Gautam-Gandhi/4-bit-CLA-Adder---VLSI-Design/README.md

# 4-bit CLA Adder - VLSI-Design
VLSI Design of a 4-bit Carry Look-Ahead Adder
