Gautam-Gandhi/4-bit-CLA-Adder---VLSI-Design/MAGIC/test_complete_circuit.cir

* SPICE3 file created from pg_block.ext - technology: scmos

.option scale=90n
.include TSMC_180nm.txt

M1000 a0 a_n69_n411# gnd Gnd CMOSN w=10 l=2
+  ad=50p pd=30u as=50p ps=30u
M1001 a_n140_n1295# b3_ff_in gnd Gnd CMOSN w=10 l=2
+  ad=50p pd=30u as=50p ps=30u
M1002 a_n104_n1165# clk gnd Gnd CMOSN w=20 l=2
+  ad=100p pd=30u as=100p ps=50u
M1003 a_n104_n371# clk gnd Gnd CMOSN w=20 l=2
+  ad=100p pd=30u as=100p ps=50u
M1004 a_100_n781# c0 a_88_n781# Gnd CMOSN w=40 l=2
+  ad=0.2n pd=50u as=0.2n ps=50u
M1005 c4 g3_inv vdd vdd CMOSP w=20 l=2
+  ad=100p pd=50u as=100p ps=30u
M1006 a_n140_n936# clk a_n140_n1000# vdd CMOSP w=40 l=2
+  ad=0.2n pd=90u as=0.2n ps=50u
M1007 b0 a_n69_n447# gnd Gnd CMOSN w=10 l=2
+  ad=50p pd=30u as=50p ps=30u
M1008 vdd a_94_n825# c3 vdd CMOSP w=20 l=2
+  ad=100p pd=30u as=100p ps=30u
M1009 a_110_n1392# a_116_n1412# a_110_n1435# Gnd CMOSN w=20 l=2
+  ad=100p pd=50u as=100p ps=30u
M1010 out_NAND3 in1_NAND3 vdd vdd CMOSP w=20 l=2
+  ad=100p pd=30u as=100p ps=50u
M1011 g1 g1_inv gnd Gnd CMOSN w=10 l=2
+  ad=50p pd=30u as=50p ps=30u
M1012 s3_ff_out a_331_n656# vdd vdd CMOSP w=20 l=2
+  ad=100p pd=50u as=100p ps=50u
M1013 p2 a_34_n808# gnd Gnd CMOSN w=10 l=2
+  ad=50p pd=30u as=50p ps=30u
M1014 a_229_n1204# c4 gnd Gnd CMOSN w=10 l=2
+  ad=50p pd=30u as=50p ps=30u
M1015 a_118_n1118# c0 a_106_n1118# Gnd CMOSN w=50 l=2
+  ad=0.25n pd=60u as=0.25n ps=60u
M1016 g1_inv a1 vdd vdd CMOSP w=20 l=2
+  ad=100p pd=30u as=100p ps=50u
M1017 s2_ff_out_inv s2_ff_out vdd vdd CMOSP w=20 l=2
+  ad=100p pd=50u as=100p ps=50u
M1018 g1_inv b1 a_n6_n659# Gnd CMOSN w=20 l=2
+  ad=100p pd=50u as=100p ps=30u
M1019 c2 a_82_n504# vdd vdd CMOSP w=20 l=2
+  ad=100p pd=30u as=100p ps=50u
M1020 a_260_n556# clk a_260_n620# vdd CMOSP w=40 l=2
+  ad=0.2n pd=90u as=0.2n ps=50u
M1021 a_88_n704# p0 vdd vdd CMOSP w=20 l=2
+  ad=100p pd=30u as=100p ps=30u
M1022 p2 c2 a_151_n725# vdd CMOSP w=40 l=2
+  ad=0.2n pd=90u as=0.2n ps=90u
M1023 a_270_n786# a_223_n811# gnd Gnd CMOSN w=10 l=2
+  ad=50p pd=30u as=50p ps=30u
M1024 out_xor a_259_n60# vdd vdd CMOSP w=20 l=2
+  ad=100p pd=50u as=100p ps=50u
M1025 a_n104_n824# clk vdd vdd CMOSP w=20 l=2
+  ad=100p pd=50u as=100p ps=50u
M1026 vdd p2 a_100_n1287# vdd CMOSP w=20 l=2
+  ad=100p pd=30u as=100p ps=30u
M1027 a_94_n825# p2 a_106_n885# Gnd CMOSN w=30 l=2
+  ad=0.15n pd=70u as=0.15n ps=40u
M1028 a_100_n1347# g1 gnd Gnd CMOSN w=30 l=2
+  ad=0.15n pd=40u as=0.15n ps=70u
M1029 a_82_n504# p1 a_94_n564# Gnd CMOSN w=30 l=2
+  ad=0.15n pd=70u as=0.15n ps=40u
M1030 vdd b2 g2_inv vdd CMOSP w=20 l=2
+  ad=100p pd=50u as=100p ps=30u
M1031 a_62_n30# in_ff vdd vdd CMOSP w=40 l=2
+  ad=0.2n pd=50u as=0.2n ps=90u
M1032 in1_xor in2_xor a_212_n29# vdd CMOSP w=40 l=2
+  ad=0.2n pd=90u as=0.2n ps=90u
M1033 out_NAND4 in4_NAND4 a_163_n234# Gnd CMOSN w=40 l=2
+  ad=0.2n pd=90u as=0.2n ps=50u
M1034 p1 a_34_n572# vdd vdd CMOSP w=20 l=2
+  ad=100p pd=50u as=100p ps=50u
M1035 a_n104_n663# clk gnd Gnd CMOSN w=20 l=2
+  ad=100p pd=30u as=100p ps=50u
M1036 s1_ff_out a_333_n442# vdd vdd CMOSP w=20 l=2
+  ad=100p pd=50u as=100p ps=50u
M1037 c4_ff_out a_300_n1150# gnd Gnd CMOSN w=10 l=2
+  ad=50p pd=30u as=50p ps=30u
M1038 a_n69_n960# a_n104_n1000# gnd Gnd CMOSN w=20 l=2
+  ad=100p pd=30u as=100p ps=50u
M1039 s0_ff_out_inv s0_ff_out vdd vdd CMOSP w=20 l=2
+  ad=100p pd=50u as=100p ps=50u
M1040 a_n140_n677# clk a_n140_n643# vdd CMOSP w=40 l=2
+  ad=0.2n pd=90u as=0.2n ps=50u
M1041 a_158_n845# a_88_n704# gnd Gnd CMOSN w=40 l=2
+  ad=0.2n pd=50u as=0.2n ps=90u
M1042 a_262_n342# clk a_262_n406# vdd CMOSP w=40 l=2
+  ad=0.2n pd=90u as=0.2n ps=50u
M1043 a_100_n1287# p3 a_112_n1347# Gnd CMOSN w=30 l=2
+  ad=0.15n pd=70u as=0.15n ps=40u
M1044 c4_ff_out_inv c4_ff_out vdd vdd CMOSP w=20 l=2
+  ad=100p pd=50u as=100p ps=50u
M1045 a_77_n217# in2_NAND3 a_65_n217# Gnd CMOSN w=30 l=2
+  ad=0.15n pd=40u as=0.15n ps=40u
M1046 a_110_n1435# p3 gnd Gnd CMOSN w=20 l=2
+  ad=100p pd=30u as=100p ps=50u
M1047 a_262_n496# s1 gnd Gnd CMOSN w=10 l=2
+  ad=50p pd=30u as=50p ps=30u
M1048 a_n13_n541# b1 gnd Gnd CMOSN w=10 l=2
+  ad=50p pd=30u as=50p ps=30u
M1049 c0 a_n69_n1000# gnd Gnd CMOSN w=10 l=2
+  ad=50p pd=30u as=50p ps=30u
M1050 s2_ff_out_inv s2_ff_out gnd Gnd CMOSN w=10 l=2
+  ad=50p pd=30u as=50p ps=30u
M1051 g2 g2_inv vdd vdd CMOSP w=20 l=2
+  ad=100p pd=50u as=100p ps=50u
M1052 s3_ff_out_inv s3_ff_out gnd Gnd CMOSN w=10 l=2
+  ad=50p pd=30u as=50p ps=30u
M1053 a_265_n1190# clk gnd Gnd CMOSN w=20 l=2
+  ad=100p pd=30u as=100p ps=50u
M1054 a_n69_n1241# a_n104_n1241# vdd vdd CMOSP w=20 l=2
+  ad=100p pd=50u as=100p ps=50u
M1055 vdd in2_NAND5 out_NAND5 vdd CMOSP w=20 l=2
+  ad=100p pd=30u as=100p ps=30u
M1056 c0 p0 a_150_n403# vdd CMOSP w=40 l=2
+  ad=0.2n pd=90u as=0.2n ps=90u
M1057 a_n69_n587# clk a_n69_n547# Gnd CMOSN w=20 l=2
+  ad=100p pd=50u as=100p ps=30u
M1058 a_n104_n587# clk vdd vdd CMOSP w=20 l=2
+  ad=100p pd=50u as=100p ps=50u
M1059 a_331_n696# a_296_n656# gnd Gnd CMOSN w=20 l=2
+  ad=100p pd=30u as=100p ps=50u
M1060 a_n69_n900# a_n104_n860# gnd Gnd CMOSN w=20 l=2
+  ad=100p pd=30u as=100p ps=50u
M1061 g3_inv b3 a_n6_n1276# Gnd CMOSN w=20 l=2
+  ad=100p pd=50u as=100p ps=30u
M1062 a_n104_n860# clk vdd vdd CMOSP w=20 l=2
+  ad=100p pd=50u as=100p ps=50u
M1063 a_100_n1287# g1 vdd vdd CMOSP w=20 l=2
+  ad=100p pd=30u as=100p ps=50u
M1064 a_300_n1150# clk a_300_n1190# Gnd CMOSN w=20 l=2
+  ad=100p pd=50u as=100p ps=30u
M1065 a_62_n64# clk a_62_n30# vdd CMOSP w=40 l=2
+  ad=0.2n pd=90u as=0.2n ps=50u
M1066 c1 p1 a_169_n498# vdd CMOSP w=40 l=2
+  ad=0.2n pd=90u as=0.2n ps=90u
M1067 a_136_n564# a_82_n504# gnd Gnd CMOSN w=30 l=2
+  ad=0.15n pd=40u as=0.15n ps=70u
M1068 a_300_n1150# a_265_n1150# vdd vdd CMOSP w=20 l=2
+  ad=100p pd=50u as=100p ps=50u
M1069 a_n69_n1165# a_n104_n1205# gnd Gnd CMOSN w=20 l=2
+  ad=100p pd=30u as=100p ps=50u
M1070 vdd in2_NAND4 out_NAND4 vdd CMOSP w=20 l=2
+  ad=100p pd=30u as=100p ps=30u
M1071 a_82_n1024# p3 a_118_n1118# Gnd CMOSN w=50 l=2
+  ad=0.25n pd=0.11m as=0.25n ps=60u
M1072 s1 a_216_n473# gnd Gnd CMOSN w=10 l=2
+  ad=50p pd=30u as=50p ps=30u
M1073 vdd a_90_n1164# c4 vdd CMOSP w=20 l=2
+  ad=100p pd=30u as=100p ps=30u
M1074 vdd p1 a_90_n1164# vdd CMOSP w=20 l=2
+  ad=100p pd=30u as=100p ps=30u
M1075 a0 a_n69_n411# vdd vdd CMOSP w=20 l=2
+  ad=100p pd=50u as=100p ps=50u
M1076 a_100_n1287# p3 vdd vdd CMOSP w=20 l=2
+  ad=100p pd=50u as=100p ps=30u
M1077 vdd in2_NAND3 out_NAND3 vdd CMOSP w=20 l=2
+  ad=100p pd=30u as=100p ps=30u
M1078 a_216_n473# a_169_n498# vdd vdd CMOSP w=20 l=2
+  ad=100p pd=50u as=100p ps=50u
M1079 a_169_n498# c1 gnd Gnd CMOSN w=10 l=2
+  ad=50p pd=30u as=50p ps=30u
M1080 vdd a_82_n608# c2 vdd CMOSP w=20 l=2
+  ad=100p pd=30u as=100p ps=30u
M1081 a2 b2 a_n13_n777# vdd CMOSP w=40 l=2
+  ad=0.2n pd=90u as=0.2n ps=90u
M1082 a_98_n10# clk vdd vdd CMOSP w=20 l=2
+  ad=100p pd=50u as=100p ps=50u
M1083 a_n69_n447# clk a_n69_n487# Gnd CMOSN w=20 l=2
+  ad=100p pd=50u as=100p ps=30u
M1084 a_n104_n587# a_n140_n523# a_n104_n547# Gnd CMOSN w=20 l=2
+  ad=100p pd=50u as=100p ps=30u
M1085 vdd p1 a_88_n704# vdd CMOSP w=20 l=2
+  ad=100p pd=50u as=100p ps=30u
M1086 a_223_n811# p3 gnd Gnd CMOSN w=10 l=2
+  ad=50p pd=30u as=50p ps=30u
M1087 p3 c3 a_223_n811# vdd CMOSP w=40 l=2
+  ad=0.2n pd=90u as=0.2n ps=90u
M1088 a_82_n1024# p2 vdd vdd CMOSP w=20 l=2
+  ad=100p pd=30u as=100p ps=50u
M1089 a_139_n234# in1_NAND4 gnd Gnd CMOSN w=40 l=2
+  ad=0.2n pd=50u as=0.2n ps=90u
M1090 a_34_n383# a_n13_n352# gnd Gnd CMOSN w=10 l=2
+  ad=50p pd=30u as=50p ps=30u
M1091 out_inv in_inv gnd Gnd CMOSN w=10 l=2
+  ad=50p pd=30u as=50p ps=30u
M1092 a_n69_n371# a_n104_n411# gnd Gnd CMOSN w=20 l=2
+  ad=100p pd=30u as=100p ps=50u
M1093 a_n69_n1205# clk a_n69_n1165# Gnd CMOSN w=20 l=2
+  ad=100p pd=50u as=100p ps=30u
M1094 a_259_n60# a_212_n29# vdd vdd CMOSP w=20 l=2
+  ad=100p pd=50u as=100p ps=50u
M1095 vdd b1 g1_inv vdd CMOSP w=20 l=2
+  ad=100p pd=50u as=100p ps=30u
M1096 c0 a_n69_n1000# vdd vdd CMOSP w=20 l=2
+  ad=100p pd=50u as=100p ps=50u
M1097 a_n140_n760# a2_ff_in gnd Gnd CMOSN w=10 l=2
+  ad=50p pd=30u as=50p ps=30u
M1098 a_170_n845# a_94_n825# a_158_n845# Gnd CMOSN w=40 l=2
+  ad=0.2n pd=50u as=0.2n ps=50u
M1099 b3 a_n69_n1241# vdd vdd CMOSP w=20 l=2
+  ad=100p pd=50u as=100p ps=50u
M1100 out_NAND3 in3_NAND3 a_77_n217# Gnd CMOSN w=30 l=2
+  ad=0.15n pd=70u as=0.15n ps=40u
M1101 a_108_n400# a_73_n357# gnd Gnd CMOSN w=20 l=2
+  ad=100p pd=30u as=100p ps=50u
M1102 a_260_n556# s2 gnd Gnd CMOSN w=10 l=2
+  ad=50p pd=30u as=50p ps=30u
M1103 a_n69_n824# clk a_n69_n784# Gnd CMOSN w=20 l=2
+  ad=100p pd=50u as=100p ps=30u
M1104 c4 a_82_n1024# vdd vdd CMOSP w=20 l=2
+  ad=100p pd=30u as=100p ps=50u
M1105 in2_xor in1_xor a_212_n29# vdd CMOSP w=40 l=2
+  ad=0.2n pd=90u as=0.2n ps=90u
M1106 a_n69_n824# a_n104_n824# vdd vdd CMOSP w=20 l=2
+  ad=100p pd=50u as=100p ps=50u
M1107 a_333_n406# a_298_n406# vdd vdd CMOSP w=20 l=2
+  ad=100p pd=50u as=100p ps=50u
M1108 a_265_n1150# a_229_n1204# a_265_n1190# Gnd CMOSN w=20 l=2
+  ad=100p pd=50u as=100p ps=30u
M1109 a_n104_n447# a_n140_n501# a_n104_n487# Gnd CMOSN w=20 l=2
+  ad=100p pd=50u as=100p ps=30u
M1110 a_90_n1164# p2 vdd vdd CMOSP w=20 l=2
+  ad=100p pd=30u as=100p ps=50u
M1111 b0 a_n69_n447# vdd vdd CMOSP w=20 l=2
+  ad=100p pd=50u as=100p ps=50u
M1112 a_n104_n623# clk vdd vdd CMOSP w=20 l=2
+  ad=100p pd=50u as=100p ps=50u
M1113 a_n69_n663# a_n104_n623# gnd Gnd CMOSN w=20 l=2
+  ad=100p pd=30u as=100p ps=50u
M1114 a_88_n704# p2 vdd vdd CMOSP w=20 l=2
+  ad=100p pd=30u as=100p ps=50u
M1115 a_n6_n1276# a3 gnd Gnd CMOSN w=20 l=2
+  ad=100p pd=30u as=100p ps=50u
M1116 g1 g1_inv vdd vdd CMOSP w=20 l=2
+  ad=100p pd=50u as=100p ps=50u
M1117 out_NAND5 in3_NAND5 vdd vdd CMOSP w=20 l=2
+  ad=100p pd=30u as=100p ps=30u
M1118 c4 g3_inv a_197_n1258# Gnd CMOSN w=50 l=2
+  ad=0.25n pd=0.11m as=0.25n ps=60u
M1119 p3 a_34_n1189# gnd Gnd CMOSN w=10 l=2
+  ad=50p pd=30u as=50p ps=30u
M1120 a_n13_n1158# b3 gnd Gnd CMOSN w=10 l=2
+  ad=50p pd=30u as=50p ps=30u
M1121 a_n104_n547# clk gnd Gnd CMOSN w=20 l=2
+  ad=100p pd=30u as=100p ps=50u
M1122 b1 a_n69_n623# gnd Gnd CMOSN w=10 l=2
+  ad=50p pd=30u as=50p ps=30u
M1123 c4 a_100_n1287# vdd vdd CMOSP w=20 l=2
+  ad=100p pd=30u as=100p ps=30u
M1124 a_90_n1164# p3 vdd vdd CMOSP w=20 l=2
+  ad=100p pd=30u as=100p ps=30u
M1125 a_148_n564# a_82_n608# a_136_n564# Gnd CMOSN w=30 l=2
+  ad=0.15n pd=40u as=0.15n ps=40u
M1126 a_n140_n501# b0_ff_in gnd Gnd CMOSN w=10 l=2
+  ad=50p pd=30u as=50p ps=30u
M1127 a_n104_n824# a_n140_n760# a_n104_n784# Gnd CMOSN w=20 l=2
+  ad=100p pd=50u as=100p ps=30u
M1128 a0 b0 a_n13_n352# vdd CMOSP w=40 l=2
+  ad=0.2n pd=90u as=0.2n ps=90u
M1129 a_n13_n777# b2 gnd Gnd CMOSN w=10 l=2
+  ad=50p pd=30u as=50p ps=30u
M1130 a_n140_n880# b2_ff_in vdd vdd CMOSP w=40 l=2
+  ad=0.2n pd=50u as=0.2n ps=90u
M1131 a_73_n400# p0 gnd Gnd CMOSN w=20 l=2
+  ad=100p pd=30u as=100p ps=50u
M1132 c4_ff_out a_300_n1150# vdd vdd CMOSP w=20 l=2
+  ad=100p pd=50u as=100p ps=50u
M1133 a_34_n1189# a_n13_n1158# gnd Gnd CMOSN w=10 l=2
+  ad=50p pd=30u as=50p ps=30u
M1134 vdd b3 g3_inv vdd CMOSP w=20 l=2
+  ad=100p pd=50u as=100p ps=30u
M1135 out_NAND3 in3_NAND3 vdd vdd CMOSP w=20 l=2
+  ad=100p pd=50u as=100p ps=30u
M1136 a_n140_n411# a0_ff_in vdd vdd CMOSP w=40 l=2
+  ad=0.2n pd=50u as=0.2n ps=90u
M1137 a_n69_n587# a_n104_n587# vdd vdd CMOSP w=20 l=2
+  ad=100p pd=50u as=100p ps=50u
M1138 a_260_n676# s3 vdd vdd CMOSP w=40 l=2
+  ad=0.2n pd=50u as=0.2n ps=90u
M1139 a_265_n1150# clk vdd vdd CMOSP w=20 l=2
+  ad=100p pd=50u as=100p ps=50u
M1140 vdd p1 a_82_n1024# vdd CMOSP w=20 l=2
+  ad=100p pd=30u as=100p ps=30u
M1141 a_331_n656# a_296_n656# vdd vdd CMOSP w=20 l=2
+  ad=100p pd=50u as=100p ps=50u
M1142 a_283_n251# in4_NAND5 a_271_n251# Gnd CMOSN w=50 l=2
+  ad=0.25n pd=60u as=0.25n ps=60u
M1143 p0 a_34_n383# gnd Gnd CMOSN w=10 l=2
+  ad=50p pd=30u as=50p ps=30u
M1144 c2 g1_inv vdd vdd CMOSP w=20 l=2
+  ad=100p pd=50u as=100p ps=30u
M1145 a_n69_n860# a_n104_n860# vdd vdd CMOSP w=20 l=2
+  ad=100p pd=50u as=100p ps=50u
M1146 a_296_n620# clk vdd vdd CMOSP w=20 l=2
+  ad=100p pd=50u as=100p ps=50u
M1147 a_n140_n760# clk a_n140_n824# vdd CMOSP w=40 l=2
+  ad=0.2n pd=90u as=0.2n ps=50u
M1148 a_n104_n487# clk gnd Gnd CMOSN w=20 l=2
+  ad=100p pd=30u as=100p ps=50u
M1149 a_n140_n523# a1_ff_in gnd Gnd CMOSN w=10 l=2
+  ad=50p pd=30u as=50p ps=30u
M1150 a_331_n580# a_296_n620# gnd Gnd CMOSN w=20 l=2
+  ad=100p pd=30u as=100p ps=50u
M1151 b2 a2 a_n13_n777# vdd CMOSP w=40 l=2
+  ad=0.2n pd=90u as=0.2n ps=90u
M1152 out_xor a_259_n60# gnd Gnd CMOSN w=10 l=2
+  ad=50p pd=30u as=50p ps=30u
M1153 a_151_n234# in2_NAND4 a_139_n234# Gnd CMOSN w=40 l=2
+  ad=0.2n pd=50u as=0.2n ps=50u
M1154 g3 g3_inv vdd vdd CMOSP w=20 l=2
+  ad=100p pd=50u as=100p ps=50u
M1155 a_n6_n470# a0 gnd Gnd CMOSN w=20 l=2
+  ad=100p pd=30u as=100p ps=50u
M1156 s3_ff_out_inv s3_ff_out vdd vdd CMOSP w=20 l=2
+  ad=100p pd=50u as=100p ps=50u
M1157 a_n6_n200# in1_NAND2 gnd Gnd CMOSN w=20 l=2
+  ad=100p pd=30u as=100p ps=50u
M1158 a_n140_n501# clk a_n140_n467# vdd CMOSP w=40 l=2
+  ad=0.2n pd=90u as=0.2n ps=50u
M1159 a_102_n1241# p1 a_90_n1241# Gnd CMOSN w=40 l=2
+  ad=0.2n pd=50u as=0.2n ps=50u
M1160 a_n140_n1000# c0_ff_in vdd vdd CMOSP w=40 l=2
+  ad=0.2n pd=50u as=0.2n ps=90u
M1161 s0_ff_out a_333_n406# gnd Gnd CMOSN w=10 l=2
+  ad=50p pd=30u as=50p ps=30u
M1162 c2 p2 a_151_n725# vdd CMOSP w=40 l=2
+  ad=0.2n pd=90u as=0.2n ps=90u
M1163 c3 a_94_n929# vdd vdd CMOSP w=20 l=2
+  ad=100p pd=30u as=100p ps=30u
M1164 s3 a_270_n786# gnd Gnd CMOSN w=10 l=2
+  ad=50p pd=30u as=50p ps=30u
M1165 a_94_n825# p1 vdd vdd CMOSP w=20 l=2
+  ad=100p pd=30u as=100p ps=50u
M1166 a_82_n504# c0 vdd vdd CMOSP w=20 l=2
+  ad=100p pd=30u as=100p ps=50u
M1167 a_333_n482# a_298_n442# gnd Gnd CMOSN w=20 l=2
+  ad=100p pd=30u as=100p ps=50u
M1168 s1_ff_out a_333_n442# gnd Gnd CMOSN w=10 l=2
+  ad=50p pd=30u as=50p ps=30u
M1169 c1 g0_inv a_108_n400# Gnd CMOSN w=20 l=2
+  ad=100p pd=50u as=100p ps=30u
M1170 a_298_n406# clk vdd vdd CMOSP w=20 l=2
+  ad=100p pd=50u as=100p ps=50u
M1171 a2 a_n69_n824# gnd Gnd CMOSN w=10 l=2
+  ad=50p pd=30u as=50p ps=30u
M1172 a_270_n786# a_223_n811# vdd vdd CMOSP w=20 l=2
+  ad=100p pd=50u as=100p ps=50u
M1173 a_n104_n784# clk gnd Gnd CMOSN w=20 l=2
+  ad=100p pd=30u as=100p ps=50u
M1174 a_n140_n1141# a3_ff_in gnd Gnd CMOSN w=10 l=2
+  ad=50p pd=30u as=50p ps=30u
M1175 b2 a_n69_n860# gnd Gnd CMOSN w=10 l=2
+  ad=50p pd=30u as=50p ps=30u
M1176 vdd a_116_n1412# a_110_n1392# vdd CMOSP w=20 l=2
+  ad=100p pd=50u as=100p ps=30u
M1177 s1_ff_out_inv s1_ff_out vdd vdd CMOSP w=20 l=2
+  ad=100p pd=50u as=100p ps=50u
M1178 vdd c0 a_88_n704# vdd CMOSP w=20 l=2
+  ad=100p pd=30u as=100p ps=30u
M1179 a_94_n929# p2 vdd vdd CMOSP w=20 l=2
+  ad=100p pd=30u as=100p ps=50u
M1180 a_n104_n1241# a_n140_n1295# a_n104_n1281# Gnd CMOSN w=20 l=2
+  ad=100p pd=50u as=100p ps=30u
M1181 vdd a_110_n1392# c4 vdd CMOSP w=20 l=2
+  ad=100p pd=30u as=100p ps=30u
M1182 vdd g0 a_90_n1164# vdd CMOSP w=20 l=2
+  ad=100p pd=50u as=100p ps=30u
M1183 a_296_n656# a_260_n710# a_296_n696# Gnd CMOSN w=20 l=2
+  ad=100p pd=50u as=100p ps=30u
M1184 c1 a_73_n357# vdd vdd CMOSP w=20 l=2
+  ad=100p pd=30u as=100p ps=50u
M1185 a_82_n608# g0 vdd vdd CMOSP w=20 l=2
+  ad=100p pd=30u as=100p ps=50u
M1186 g2 g2_inv gnd Gnd CMOSN w=10 l=2
+  ad=50p pd=30u as=50p ps=30u
M1187 a_173_n1258# a_90_n1164# a_161_n1258# Gnd CMOSN w=50 l=2
+  ad=0.25n pd=60u as=0.25n ps=60u
M1188 a_n140_n523# clk a_n140_n587# vdd CMOSP w=40 l=2
+  ad=0.2n pd=90u as=0.2n ps=50u
M1189 a_82_n1024# p0 vdd vdd CMOSP w=20 l=2
+  ad=100p pd=30u as=100p ps=30u
M1190 a_n140_n643# b1_ff_in vdd vdd CMOSP w=40 l=2
+  ad=0.2n pd=50u as=0.2n ps=90u
M1191 a_112_n781# p0 a_100_n781# Gnd CMOSN w=40 l=2
+  ad=0.2n pd=50u as=0.2n ps=50u
M1192 c2 g1_inv a_148_n564# Gnd CMOSN w=30 l=2
+  ad=0.15n pd=70u as=0.15n ps=40u
M1193 a_34_n383# a_n13_n352# vdd vdd CMOSP w=20 l=2
+  ad=100p pd=50u as=100p ps=50u
M1194 a_198_n700# a_151_n725# gnd Gnd CMOSN w=10 l=2
+  ad=50p pd=30u as=50p ps=30u
M1195 g3_inv a3 vdd vdd CMOSP w=20 l=2
+  ad=100p pd=30u as=100p ps=50u
M1196 out_inv in_inv vdd vdd CMOSP w=20 l=2
+  ad=100p pd=50u as=100p ps=50u
M1197 a_260_n710# s3 gnd Gnd CMOSN w=10 l=2
+  ad=50p pd=30u as=50p ps=30u
M1198 a_229_n1170# c4 vdd vdd CMOSP w=40 l=2
+  ad=0.2n pd=50u as=0.2n ps=90u
M1199 a_n104_n1205# clk vdd vdd CMOSP w=20 l=2
+  ad=100p pd=50u as=100p ps=50u
M1200 a_n104_n411# clk vdd vdd CMOSP w=20 l=2
+  ad=100p pd=50u as=100p ps=50u
M1201 a_73_n357# c0 a_73_n400# Gnd CMOSN w=20 l=2
+  ad=100p pd=50u as=100p ps=30u
M1202 a_298_n442# a_262_n496# a_298_n482# Gnd CMOSN w=20 l=2
+  ad=100p pd=50u as=100p ps=30u
M1203 a_n69_n623# a_n104_n623# vdd vdd CMOSP w=20 l=2
+  ad=100p pd=50u as=100p ps=50u
M1204 a_90_n1241# p2 gnd Gnd CMOSN w=40 l=2
+  ad=0.2n pd=50u as=0.2n ps=90u
M1205 a_82_n1118# p2 gnd Gnd CMOSN w=50 l=2
+  ad=0.25n pd=60u as=0.25n ps=0.11m
M1206 a_94_n972# p2 gnd Gnd CMOSN w=20 l=2
+  ad=100p pd=30u as=100p ps=50u
M1207 out_ff a_133_n10# gnd Gnd CMOSN w=10 l=2
+  ad=50p pd=30u as=50p ps=30u
M1208 p0 c0 a_150_n403# vdd CMOSP w=40 l=2
+  ad=0.2n pd=90u as=0.2n ps=90u
M1209 a_82_n651# g0 gnd Gnd CMOSN w=20 l=2
+  ad=100p pd=30u as=100p ps=50u
M1210 a_296_n696# clk gnd Gnd CMOSN w=20 l=2
+  ad=100p pd=30u as=100p ps=50u
M1211 a_247_n251# in1_NAND5 gnd Gnd CMOSN w=50 l=2
+  ad=0.25n pd=60u as=0.25n ps=0.11m
M1212 b0 a0 a_n13_n352# vdd CMOSP w=40 l=2
+  ad=0.2n pd=90u as=0.2n ps=90u
M1213 a_110_n1392# p3 vdd vdd CMOSP w=20 l=2
+  ad=100p pd=30u as=100p ps=50u
M1214 a_n140_n1261# b3_ff_in vdd vdd CMOSP w=40 l=2
+  ad=0.2n pd=50u as=0.2n ps=90u
M1215 b3 a3 a_n13_n1158# vdd CMOSP w=40 l=2
+  ad=0.2n pd=90u as=0.2n ps=90u
M1216 a_260_n620# s2 vdd vdd CMOSP w=40 l=2
+  ad=0.2n pd=50u as=0.2n ps=90u
M1217 a_n6_n895# a2 gnd Gnd CMOSN w=20 l=2
+  ad=100p pd=30u as=100p ps=50u
M1218 a_94_n885# p1 gnd Gnd CMOSN w=30 l=2
+  ad=0.15n pd=40u as=0.15n ps=70u
M1219 out_NAND5 in5_NAND5 a_283_n251# Gnd CMOSN w=50 l=2
+  ad=0.25n pd=0.11m as=0.25n ps=60u
M1220 a_262_n342# s0 gnd Gnd CMOSN w=10 l=2
+  ad=50p pd=30u as=50p ps=30u
M1221 a_n69_n547# a_n104_n587# gnd Gnd CMOSN w=20 l=2
+  ad=100p pd=30u as=100p ps=50u
M1222 a_34_n572# a_n13_n541# gnd Gnd CMOSN w=10 l=2
+  ad=50p pd=30u as=50p ps=30u
M1223 a_82_n564# c0 gnd Gnd CMOSN w=30 l=2
+  ad=0.15n pd=40u as=0.15n ps=70u
M1224 a_331_n656# clk a_331_n696# Gnd CMOSN w=20 l=2
+  ad=100p pd=50u as=100p ps=30u
M1225 s2_ff_out a_331_n620# vdd vdd CMOSP w=20 l=2
+  ad=100p pd=50u as=100p ps=50u
M1226 a_114_n1241# p3 a_102_n1241# Gnd CMOSN w=40 l=2
+  ad=0.2n pd=50u as=0.2n ps=50u
M1227 a_73_n357# p0 vdd vdd CMOSP w=20 l=2
+  ad=100p pd=30u as=100p ps=50u
M1228 a_161_n1258# a_82_n1024# gnd Gnd CMOSN w=50 l=2
+  ad=0.25n pd=60u as=0.25n ps=0.11m
M1229 out_NAND4 in3_NAND4 vdd vdd CMOSP w=20 l=2
+  ad=100p pd=30u as=100p ps=30u
M1230 a_n104_n1000# clk vdd vdd CMOSP w=20 l=2
+  ad=100p pd=50u as=100p ps=50u
M1231 a_n69_n1000# clk a_n69_n960# Gnd CMOSN w=20 l=2
+  ad=100p pd=50u as=100p ps=30u
M1232 a_298_n482# clk gnd Gnd CMOSN w=20 l=2
+  ad=100p pd=30u as=100p ps=50u
M1233 s1 a_216_n473# vdd vdd CMOSP w=20 l=2
+  ad=100p pd=50u as=100p ps=50u
M1234 a1 a_n69_n587# gnd Gnd CMOSN w=10 l=2
+  ad=50p pd=30u as=50p ps=30u
M1235 vdd p0 a_82_n504# vdd CMOSP w=20 l=2
+  ad=100p pd=30u as=100p ps=30u
M1236 a_333_n442# clk a_333_n482# Gnd CMOSN w=20 l=2
+  ad=100p pd=50u as=100p ps=30u
M1237 vdd g2_inv c3 vdd CMOSP w=20 l=2
+  ad=100p pd=50u as=100p ps=30u
M1238 a3 a_n69_n1205# gnd Gnd CMOSN w=10 l=2
+  ad=50p pd=30u as=50p ps=30u
M1239 a_259_n60# a_212_n29# gnd Gnd CMOSN w=10 l=2
+  ad=50p pd=30u as=50p ps=30u
M1240 s0_ff_out a_333_n406# vdd vdd CMOSP w=20 l=2
+  ad=100p pd=50u as=100p ps=50u
M1241 a_197_n378# a_150_n403# gnd Gnd CMOSN w=10 l=2
+  ad=50p pd=30u as=50p ps=30u
M1242 g0 g0_inv gnd Gnd CMOSN w=10 l=2
+  ad=50p pd=30u as=50p ps=30u
M1243 b3 a_n69_n1241# gnd Gnd CMOSN w=10 l=2
+  ad=50p pd=30u as=50p ps=30u
M1244 a_n69_n487# a_n104_n447# gnd Gnd CMOSN w=20 l=2
+  ad=100p pd=30u as=100p ps=50u
M1245 g0_inv b0 a_n6_n470# Gnd CMOSN w=20 l=2
+  ad=100p pd=50u as=100p ps=30u
M1246 a2 a_n69_n824# vdd vdd CMOSP w=20 l=2
+  ad=100p pd=50u as=100p ps=50u
M1247 a_185_n1258# a_100_n1287# a_173_n1258# Gnd CMOSN w=50 l=2
+  ad=0.25n pd=60u as=0.25n ps=60u
M1248 a_n140_n1295# clk a_n140_n1261# vdd CMOSP w=40 l=2
+  ad=0.2n pd=90u as=0.2n ps=50u
M1249 a_212_n29# in1_xor gnd Gnd CMOSN w=10 l=2
+  ad=50p pd=30u as=50p ps=30u
M1250 out_NAND2 in1_NAND2 vdd vdd CMOSP w=20 l=2
+  ad=100p pd=30u as=100p ps=50u
M1251 out_NAND2 in2_NAND2 a_n6_n200# Gnd CMOSN w=20 l=2
+  ad=100p pd=50u as=100p ps=30u
M1252 g0_inv a0 vdd vdd CMOSP w=20 l=2
+  ad=100p pd=30u as=100p ps=50u
M1253 a_n104_n447# clk vdd vdd CMOSP w=20 l=2
+  ad=100p pd=50u as=100p ps=50u
M1254 a_198_n700# a_151_n725# vdd vdd CMOSP w=20 l=2
+  ad=100p pd=50u as=100p ps=50u
M1255 vdd c0 a_82_n1024# vdd CMOSP w=20 l=2
+  ad=100p pd=30u as=100p ps=30u
M1256 s2_ff_out a_331_n620# gnd Gnd CMOSN w=10 l=2
+  ad=50p pd=30u as=50p ps=30u
M1257 a_34_n808# a_n13_n777# vdd vdd CMOSP w=20 l=2
+  ad=100p pd=50u as=100p ps=50u
M1258 a_133_n50# a_98_n10# gnd Gnd CMOSN w=20 l=2
+  ad=100p pd=30u as=100p ps=50u
M1259 vdd g0_inv c1 vdd CMOSP w=20 l=2
+  ad=100p pd=50u as=100p ps=30u
M1260 a_262_n462# s1 vdd vdd CMOSP w=40 l=2
+  ad=0.2n pd=50u as=0.2n ps=90u
M1261 vdd p1 a_82_n608# vdd CMOSP w=20 l=2
+  ad=100p pd=50u as=100p ps=30u
M1262 a_n69_n860# clk a_n69_n900# Gnd CMOSN w=20 l=2
+  ad=100p pd=50u as=100p ps=30u
M1263 a_n104_n1000# a_n140_n936# a_n104_n960# Gnd CMOSN w=20 l=2
+  ad=100p pd=50u as=100p ps=30u
M1264 p0 a_34_n383# vdd vdd CMOSP w=20 l=2
+  ad=100p pd=50u as=100p ps=50u
M1265 a_333_n442# a_298_n442# vdd vdd CMOSP w=20 l=2
+  ad=100p pd=50u as=100p ps=50u
M1266 s3_ff_out a_331_n656# gnd Gnd CMOSN w=10 l=2
+  ad=50p pd=30u as=50p ps=30u
M1267 a_n104_n1281# clk gnd Gnd CMOSN w=20 l=2
+  ad=100p pd=30u as=100p ps=50u
M1268 a_229_n1204# clk a_229_n1170# vdd CMOSP w=40 l=2
+  ad=0.2n pd=90u as=0.2n ps=50u
M1269 a_98_n50# clk gnd Gnd CMOSN w=20 l=2
+  ad=100p pd=30u as=100p ps=50u
M1270 a_98_n10# a_62_n64# a_98_n50# Gnd CMOSN w=20 l=2
+  ad=100p pd=50u as=100p ps=30u
M1271 a1 b1 a_n13_n541# vdd CMOSP w=40 l=2
+  ad=0.2n pd=90u as=0.2n ps=90u
M1272 s2 a_198_n700# gnd Gnd CMOSN w=10 l=2
+  ad=50p pd=30u as=50p ps=30u
M1273 a_88_n704# p1 a_112_n781# Gnd CMOSN w=40 l=2
+  ad=0.2n pd=90u as=0.2n ps=50u
M1274 a_182_n845# a_94_n929# a_170_n845# Gnd CMOSN w=40 l=2
+  ad=0.2n pd=50u as=0.2n ps=50u
M1275 a_n69_n1205# a_n104_n1205# vdd vdd CMOSP w=20 l=2
+  ad=100p pd=50u as=100p ps=50u
M1276 a_94_n1118# p1 a_82_n1118# Gnd CMOSN w=50 l=2
+  ad=0.25n pd=60u as=0.25n ps=60u
M1277 a_n69_n784# a_n104_n824# gnd Gnd CMOSN w=20 l=2
+  ad=100p pd=30u as=100p ps=50u
M1278 vdd g0 a_94_n825# vdd CMOSP w=20 l=2
+  ad=100p pd=30u as=100p ps=30u
M1279 a_333_n366# a_298_n406# gnd Gnd CMOSN w=20 l=2
+  ad=100p pd=30u as=100p ps=50u
M1280 p1 c1 a_169_n498# vdd CMOSP w=40 l=2
+  ad=0.2n pd=90u as=0.2n ps=90u
M1281 a_151_n725# c2 gnd Gnd CMOSN w=10 l=2
+  ad=50p pd=30u as=50p ps=30u
M1282 a_n13_n352# b0 gnd Gnd CMOSN w=10 l=2
+  ad=50p pd=30u as=50p ps=30u
M1283 p1 a_34_n572# gnd Gnd CMOSN w=10 l=2
+  ad=50p pd=30u as=50p ps=30u
M1284 a_62_n64# in_ff gnd Gnd CMOSN w=10 l=2
+  ad=50p pd=30u as=50p ps=30u
M1285 a_259_n251# in2_NAND5 a_247_n251# Gnd CMOSN w=50 l=2
+  ad=0.25n pd=60u as=0.25n ps=60u
M1286 a_216_n473# a_169_n498# gnd Gnd CMOSN w=10 l=2
+  ad=50p pd=30u as=50p ps=30u
M1287 a_82_n608# p1 a_82_n651# Gnd CMOSN w=20 l=2
+  ad=100p pd=50u as=100p ps=30u
M1288 a_90_n1164# g0 a_114_n1241# Gnd CMOSN w=40 l=2
+  ad=0.2n pd=90u as=0.2n ps=50u
M1289 vdd in4_NAND5 out_NAND5 vdd CMOSP w=20 l=2
+  ad=100p pd=30u as=100p ps=30u
M1290 vdd g1 a_94_n929# vdd CMOSP w=20 l=2
+  ad=100p pd=50u as=100p ps=30u
M1291 a_n104_n1205# a_n140_n1141# a_n104_n1165# Gnd CMOSN w=20 l=2
+  ad=100p pd=50u as=100p ps=30u
M1292 a_n140_n347# a0_ff_in gnd Gnd CMOSN w=10 l=2
+  ad=50p pd=30u as=50p ps=30u
M1293 a1 a_n69_n587# vdd vdd CMOSP w=20 l=2
+  ad=100p pd=50u as=100p ps=50u
M1294 a_94_n564# p0 a_82_n564# Gnd CMOSN w=30 l=2
+  ad=0.15n pd=40u as=0.15n ps=40u
M1295 a_n104_n860# a_n140_n914# a_n104_n900# Gnd CMOSN w=20 l=2
+  ad=100p pd=50u as=100p ps=30u
M1296 c4_ff_out_inv c4_ff_out gnd Gnd CMOSN w=10 l=2
+  ad=50p pd=30u as=50p ps=30u
M1297 a_n140_n1205# a3_ff_in vdd vdd CMOSP w=40 l=2
+  ad=0.2n pd=50u as=0.2n ps=90u
M1298 a_296_n620# a_260_n556# a_296_n580# Gnd CMOSN w=20 l=2
+  ad=100p pd=50u as=100p ps=30u
M1299 a_n6_n659# a1 gnd Gnd CMOSN w=20 l=2
+  ad=100p pd=30u as=100p ps=50u
M1300 b2 a_n69_n860# vdd vdd CMOSP w=20 l=2
+  ad=100p pd=50u as=100p ps=50u
M1301 a_133_n10# a_98_n10# vdd vdd CMOSP w=20 l=2
+  ad=100p pd=50u as=100p ps=50u
M1302 vdd c0 a_73_n357# vdd CMOSP w=20 l=2
+  ad=100p pd=50u as=100p ps=30u
M1303 a_133_n10# clk a_133_n50# Gnd CMOSN w=20 l=2
+  ad=100p pd=50u as=100p ps=30u
M1304 vdd in4_NAND4 out_NAND4 vdd CMOSP w=20 l=2
+  ad=100p pd=50u as=100p ps=30u
M1305 a_n69_n411# clk a_n69_n371# Gnd CMOSN w=20 l=2
+  ad=100p pd=50u as=100p ps=30u
M1306 a_197_n378# a_150_n403# vdd vdd CMOSP w=20 l=2
+  ad=100p pd=50u as=100p ps=50u
M1307 a_n69_n411# a_n104_n411# vdd vdd CMOSP w=20 l=2
+  ad=100p pd=50u as=100p ps=50u
M1308 a_88_n781# p2 gnd Gnd CMOSN w=40 l=2
+  ad=0.2n pd=50u as=0.2n ps=90u
M1309 c3 p3 a_223_n811# vdd CMOSP w=40 l=2
+  ad=0.2n pd=90u as=0.2n ps=90u
M1310 c3 a_88_n704# vdd vdd CMOSP w=20 l=2
+  ad=100p pd=30u as=100p ps=50u
M1311 g2_inv b2 a_n6_n895# Gnd CMOSN w=20 l=2
+  ad=100p pd=50u as=100p ps=30u
M1312 a_n104_n960# clk gnd Gnd CMOSN w=20 l=2
+  ad=100p pd=30u as=100p ps=50u
M1313 a_296_n656# clk vdd vdd CMOSP w=20 l=2
+  ad=100p pd=50u as=100p ps=50u
M1314 g2_inv a2 vdd vdd CMOSP w=20 l=2
+  ad=100p pd=30u as=100p ps=50u
M1315 a_197_n1258# a_110_n1392# a_185_n1258# Gnd CMOSN w=50 l=2
+  ad=0.25n pd=60u as=0.25n ps=60u
M1316 g3 g3_inv gnd Gnd CMOSN w=10 l=2
+  ad=50p pd=30u as=50p ps=30u
M1317 s0 a_197_n378# gnd Gnd CMOSN w=10 l=2
+  ad=50p pd=30u as=50p ps=30u
M1318 a_260_n710# clk a_260_n676# vdd CMOSP w=40 l=2
+  ad=0.2n pd=90u as=0.2n ps=50u
M1319 a_n140_n914# b2_ff_in gnd Gnd CMOSN w=10 l=2
+  ad=50p pd=30u as=50p ps=30u
M1320 a_94_n929# g1 a_94_n972# Gnd CMOSN w=20 l=2
+  ad=100p pd=50u as=100p ps=30u
M1321 a_298_n406# a_262_n342# a_298_n366# Gnd CMOSN w=20 l=2
+  ad=100p pd=50u as=100p ps=30u
M1322 a_82_n1024# p3 vdd vdd CMOSP w=20 l=2
+  ad=100p pd=50u as=100p ps=30u
M1323 a_296_n580# clk gnd Gnd CMOSN w=20 l=2
+  ad=100p pd=30u as=100p ps=50u
M1324 a_34_n808# a_n13_n777# gnd Gnd CMOSN w=10 l=2
+  ad=50p pd=30u as=50p ps=30u
M1325 a3 a_n69_n1205# vdd vdd CMOSP w=20 l=2
+  ad=100p pd=50u as=100p ps=50u
M1326 a_106_n1118# p0 a_94_n1118# Gnd CMOSN w=50 l=2
+  ad=0.25n pd=60u as=0.25n ps=60u
M1327 a_150_n403# p0 gnd Gnd CMOSN w=10 l=2
+  ad=50p pd=30u as=50p ps=30u
M1328 a_n69_n623# clk a_n69_n663# Gnd CMOSN w=20 l=2
+  ad=100p pd=50u as=100p ps=30u
M1329 p2 a_34_n808# vdd vdd CMOSP w=20 l=2
+  ad=100p pd=50u as=100p ps=50u
M1330 a_106_n885# g0 a_94_n885# Gnd CMOSN w=30 l=2
+  ad=0.15n pd=40u as=0.15n ps=40u
M1331 out_ff a_133_n10# vdd vdd CMOSP w=20 l=2
+  ad=100p pd=50u as=100p ps=50u
M1332 s2 a_198_n700# vdd vdd CMOSP w=20 l=2
+  ad=100p pd=50u as=100p ps=50u
M1333 a_n140_n824# a2_ff_in vdd vdd CMOSP w=40 l=2
+  ad=0.2n pd=50u as=0.2n ps=90u
M1334 a_n140_n1141# clk a_n140_n1205# vdd CMOSP w=40 l=2
+  ad=0.2n pd=90u as=0.2n ps=50u
M1335 a_n69_n1000# a_n104_n1000# vdd vdd CMOSP w=20 l=2
+  ad=100p pd=50u as=100p ps=50u
M1336 a_163_n234# in3_NAND4 a_151_n234# Gnd CMOSN w=40 l=2
+  ad=0.2n pd=50u as=0.2n ps=50u
M1337 s0_ff_out_inv s0_ff_out gnd Gnd CMOSN w=10 l=2
+  ad=50p pd=30u as=50p ps=30u
M1338 a_331_n620# clk a_331_n580# Gnd CMOSN w=20 l=2
+  ad=100p pd=50u as=100p ps=30u
M1339 a_n104_n411# a_n140_n347# a_n104_n371# Gnd CMOSN w=20 l=2
+  ad=100p pd=50u as=100p ps=30u
M1340 a_298_n442# clk vdd vdd CMOSP w=20 l=2
+  ad=100p pd=50u as=100p ps=50u
M1341 a_n69_n1281# a_n104_n1241# gnd Gnd CMOSN w=20 l=2
+  ad=100p pd=30u as=100p ps=50u
M1342 a_n140_n467# b0_ff_in vdd vdd CMOSP w=40 l=2
+  ad=0.2n pd=50u as=0.2n ps=90u
M1343 a_262_n496# clk a_262_n462# vdd CMOSP w=40 l=2
+  ad=0.2n pd=90u as=0.2n ps=50u
M1344 s1_ff_out_inv s1_ff_out gnd Gnd CMOSN w=10 l=2
+  ad=50p pd=30u as=50p ps=30u
M1345 a_262_n406# s0 vdd vdd CMOSP w=40 l=2
+  ad=0.2n pd=50u as=0.2n ps=90u
M1346 a_34_n572# a_n13_n541# vdd vdd CMOSP w=20 l=2
+  ad=100p pd=50u as=100p ps=50u
M1347 s3 a_270_n786# vdd vdd CMOSP w=20 l=2
+  ad=100p pd=50u as=100p ps=50u
M1348 a_n104_n900# clk gnd Gnd CMOSN w=20 l=2
+  ad=100p pd=30u as=100p ps=50u
M1349 a_n140_n936# c0_ff_in gnd Gnd CMOSN w=10 l=2
+  ad=50p pd=30u as=50p ps=30u
M1350 a_65_n217# in1_NAND3 gnd Gnd CMOSN w=30 l=2
+  ad=0.15n pd=40u as=0.15n ps=70u
M1351 a_298_n366# clk gnd Gnd CMOSN w=20 l=2
+  ad=100p pd=30u as=100p ps=50u
M1352 vdd b0 g0_inv vdd CMOSP w=20 l=2
+  ad=100p pd=50u as=100p ps=30u
M1353 c3 g2_inv a_182_n845# Gnd CMOSN w=40 l=2
+  ad=0.2n pd=90u as=0.2n ps=50u
M1354 vdd in2_NAND2 out_NAND2 vdd CMOSP w=20 l=2
+  ad=100p pd=50u as=100p ps=30u
M1355 a_94_n825# p2 vdd vdd CMOSP w=20 l=2
+  ad=100p pd=50u as=100p ps=30u
M1356 a_300_n1190# a_265_n1150# gnd Gnd CMOSN w=20 l=2
+  ad=100p pd=30u as=100p ps=50u
M1357 b1 a1 a_n13_n541# vdd CMOSP w=40 l=2
+  ad=0.2n pd=90u as=0.2n ps=90u
M1358 a_n140_n914# clk a_n140_n880# vdd CMOSP w=40 l=2
+  ad=0.2n pd=90u as=0.2n ps=50u
M1359 a_333_n406# clk a_333_n366# Gnd CMOSN w=20 l=2
+  ad=100p pd=50u as=100p ps=30u
M1360 a_n69_n447# a_n104_n447# vdd vdd CMOSP w=20 l=2
+  ad=100p pd=50u as=100p ps=50u
M1361 a_82_n504# p1 vdd vdd CMOSP w=20 l=2
+  ad=100p pd=50u as=100p ps=30u
M1362 a_112_n1347# p2 a_100_n1347# Gnd CMOSN w=30 l=2
+  ad=0.15n pd=40u as=0.15n ps=40u
M1363 a_n140_n347# clk a_n140_n411# vdd CMOSP w=40 l=2
+  ad=0.2n pd=90u as=0.2n ps=50u
M1364 a_n140_n677# b1_ff_in gnd Gnd CMOSN w=10 l=2
+  ad=50p pd=30u as=50p ps=30u
M1365 p3 a_34_n1189# vdd vdd CMOSP w=20 l=2
+  ad=100p pd=50u as=100p ps=50u
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
