Gautam-Gandhi/4-bit-CLA-Adder---VLSI-Design/MAGIC/test_pg_block.spice

* SPICE3 file created from pg_block.ext - technology: scmos

.option scale=90n
.include TSMC_180nm.txt

M1000 g1 g1_inv gnd Gnd CMOSN w=10 l=2
+  ad=50p pd=30u as=50p ps=30u
M1001 out_NAND3 in1_NAND3 vdd vdd CMOSP w=20 l=2
+  ad=100p pd=30u as=100p ps=50u
M1002 g1_inv b1 a_n6_n659# Gnd CMOSN w=20 l=2
+  ad=100p pd=50u as=100p ps=30u
M1003 g1_inv a1 vdd vdd CMOSP w=20 l=2
+  ad=100p pd=30u as=100p ps=50u
M1004 g0 g0_inv gnd Gnd CMOSN w=10 l=2
+  ad=50p pd=30u as=50p ps=30u
M1005 out_xor a_259_n60# vdd vdd CMOSP w=20 l=2
+  ad=100p pd=50u as=100p ps=50u
M1006 a_62_n30# in_ff w_49_n36# w_49_n36# CMOSP w=40 l=2
+  ad=0.2n pd=50u as=0.2n ps=90u
M1007 p1 a_34_n572# vdd vdd CMOSP w=20 l=2
+  ad=100p pd=50u as=100p ps=50u
M1008 out_NAND4 in4_NAND4 a_163_n234# Gnd CMOSN w=40 l=2
+  ad=0.2n pd=90u as=0.2n ps=50u
M1009 in1_xor in2_xor a_212_n29# vdd CMOSP w=40 l=2
+  ad=0.2n pd=90u as=0.2n ps=90u
M1010 a2 b2 a_n13_n725# vdd CMOSP w=40 l=2
+  ad=0.2n pd=90u as=0.2n ps=90u
M1011 a_77_n217# in2_NAND3 a_65_n217# Gnd CMOSN w=30 l=2
+  ad=0.15n pd=40u as=0.15n ps=40u
M1012 p2 a_34_n756# gnd Gnd CMOSN w=10 l=2
+  ad=50p pd=30u as=50p ps=30u
M1013 a_n13_n541# b1 gnd Gnd CMOSN w=10 l=2
+  ad=50p pd=30u as=50p ps=30u
M1014 a_n6_n477# a0 gnd Gnd CMOSN w=20 l=2
+  ad=100p pd=30u as=100p ps=50u
M1015 a_n6_n1025# a3 gnd Gnd CMOSN w=20 l=2
+  ad=100p pd=30u as=100p ps=50u
M1016 a_n13_n359# b0 gnd Gnd CMOSN w=10 l=2
+  ad=50p pd=30u as=50p ps=30u
M1017 a_n13_n907# b3 gnd Gnd CMOSN w=10 l=2
+  ad=50p pd=30u as=50p ps=30u
M1018 vdd in2_NAND5 out_NAND5 vdd CMOSP w=20 l=2
+  ad=100p pd=30u as=100p ps=30u
M1019 a_62_n64# clk a_62_n30# w_49_n36# CMOSP w=40 l=2
+  ad=0.2n pd=90u as=0.2n ps=50u
M1020 vdd in2_NAND4 out_NAND4 vdd CMOSP w=20 l=2
+  ad=100p pd=30u as=100p ps=30u
M1021 vdd in2_NAND3 out_NAND3 vdd CMOSP w=20 l=2
+  ad=100p pd=30u as=100p ps=30u
M1022 a_98_n10# clk w_49_n36# w_49_n36# CMOSP w=20 l=2
+  ad=100p pd=50u as=100p ps=50u
M1023 a_34_n938# a_n13_n907# vdd vdd CMOSP w=20 l=2
+  ad=100p pd=50u as=100p ps=50u
M1024 a_34_n390# a_n13_n359# vdd vdd CMOSP w=20 l=2
+  ad=100p pd=50u as=100p ps=50u
M1025 a_139_n234# in1_NAND4 gnd Gnd CMOSN w=40 l=2
+  ad=0.2n pd=50u as=0.2n ps=90u
M1026 a_34_n756# a_n13_n725# vdd vdd CMOSP w=20 l=2
+  ad=100p pd=50u as=100p ps=50u
M1027 out_inv in_inv gnd Gnd CMOSN w=10 l=2
+  ad=50p pd=30u as=50p ps=30u
M1028 vdd b1 g1_inv vdd CMOSP w=20 l=2
+  ad=100p pd=50u as=100p ps=30u
M1029 a_259_n60# a_212_n29# vdd vdd CMOSP w=20 l=2
+  ad=100p pd=50u as=100p ps=50u
M1030 b2 a2 a_n13_n725# vdd CMOSP w=40 l=2
+  ad=0.2n pd=90u as=0.2n ps=90u
M1031 out_NAND3 in3_NAND3 a_77_n217# Gnd CMOSN w=30 l=2
+  ad=0.15n pd=70u as=0.15n ps=40u
M1032 in2_xor in1_xor a_212_n29# vdd CMOSP w=40 l=2
+  ad=0.2n pd=90u as=0.2n ps=90u
M1033 g1 g1_inv vdd vdd CMOSP w=20 l=2
+  ad=100p pd=50u as=100p ps=50u
M1034 out_NAND5 in3_NAND5 vdd vdd CMOSP w=20 l=2
+  ad=100p pd=30u as=100p ps=30u
M1035 g0_inv b0 a_n6_n477# Gnd CMOSN w=20 l=2
+  ad=100p pd=50u as=100p ps=30u
M1036 g0_inv a0 vdd vdd CMOSP w=20 l=2
+  ad=100p pd=30u as=100p ps=50u
M1037 g2 g2_inv gnd Gnd CMOSN w=10 l=2
+  ad=50p pd=30u as=50p ps=30u
M1038 p3 a_34_n938# vdd vdd CMOSP w=20 l=2
+  ad=100p pd=50u as=100p ps=50u
M1039 p0 a_34_n390# vdd vdd CMOSP w=20 l=2
+  ad=100p pd=50u as=100p ps=50u
M1040 out_NAND3 in3_NAND3 vdd vdd CMOSP w=20 l=2
+  ad=100p pd=50u as=100p ps=30u
M1041 a_283_n251# in4_NAND5 a_271_n251# Gnd CMOSN w=50 l=2
+  ad=0.25n pd=60u as=0.25n ps=60u
M1042 p2 a_34_n756# vdd vdd CMOSP w=20 l=2
+  ad=100p pd=50u as=100p ps=50u
M1043 a_151_n234# in2_NAND4 a_139_n234# Gnd CMOSN w=40 l=2
+  ad=0.2n pd=50u as=0.2n ps=50u
M1044 out_xor a_259_n60# gnd Gnd CMOSN w=10 l=2
+  ad=50p pd=30u as=50p ps=30u
M1045 a_n6_n843# a2 gnd Gnd CMOSN w=20 l=2
+  ad=100p pd=30u as=100p ps=50u
M1046 a_n6_n200# in1_NAND2 gnd Gnd CMOSN w=20 l=2
+  ad=100p pd=30u as=100p ps=50u
M1047 a_n13_n725# b2 gnd Gnd CMOSN w=10 l=2
+  ad=50p pd=30u as=50p ps=30u
M1048 out_inv in_inv vdd vdd CMOSP w=20 l=2
+  ad=100p pd=50u as=100p ps=50u
M1049 out_ff a_133_n10# a_51_n72# Gnd CMOSN w=10 l=2
+  ad=50p pd=30u as=50p ps=30u
M1050 a_247_n251# in1_NAND5 gnd Gnd CMOSN w=50 l=2
+  ad=0.25n pd=60u as=0.25n ps=0.11m
M1051 vdd b0 g0_inv vdd CMOSP w=20 l=2
+  ad=100p pd=50u as=100p ps=30u
M1052 g3_inv a3 vdd vdd CMOSP w=20 l=2
+  ad=100p pd=30u as=100p ps=50u
M1053 a_34_n572# a_n13_n541# gnd Gnd CMOSN w=10 l=2
+  ad=50p pd=30u as=50p ps=30u
M1054 out_NAND5 in5_NAND5 a_283_n251# Gnd CMOSN w=50 l=2
+  ad=0.25n pd=0.11m as=0.25n ps=60u
M1055 a_34_n390# a_n13_n359# gnd Gnd CMOSN w=10 l=2
+  ad=50p pd=30u as=50p ps=30u
M1056 out_NAND4 in3_NAND4 vdd vdd CMOSP w=20 l=2
+  ad=100p pd=30u as=100p ps=30u
M1057 a_34_n938# a_n13_n907# gnd Gnd CMOSN w=10 l=2
+  ad=50p pd=30u as=50p ps=30u
M1058 g2_inv a2 vdd vdd CMOSP w=20 l=2
+  ad=100p pd=30u as=100p ps=50u
M1059 g3 g3_inv gnd Gnd CMOSN w=10 l=2
+  ad=50p pd=30u as=50p ps=30u
M1060 g0 g0_inv vdd vdd CMOSP w=20 l=2
+  ad=100p pd=50u as=100p ps=50u
M1061 a_259_n60# a_212_n29# gnd Gnd CMOSN w=10 l=2
+  ad=50p pd=30u as=50p ps=30u
M1062 g2_inv b2 a_n6_n843# Gnd CMOSN w=20 l=2
+  ad=100p pd=50u as=100p ps=30u
M1063 out_NAND2 in2_NAND2 a_n6_n200# Gnd CMOSN w=20 l=2
+  ad=100p pd=50u as=100p ps=30u
M1064 out_NAND2 in1_NAND2 vdd vdd CMOSP w=20 l=2
+  ad=100p pd=30u as=100p ps=50u
M1065 a_212_n29# in1_xor gnd Gnd CMOSN w=10 l=2
+  ad=50p pd=30u as=50p ps=30u
M1066 a_133_n50# a_98_n10# a_51_n72# Gnd CMOSN w=20 l=2
+  ad=100p pd=30u as=100p ps=50u
M1067 a1 b1 a_n13_n541# vdd CMOSP w=40 l=2
+  ad=0.2n pd=90u as=0.2n ps=90u
M1068 a_98_n10# a_62_n64# a_98_n50# Gnd CMOSN w=20 l=2
+  ad=100p pd=50u as=100p ps=30u
M1069 a_98_n50# clk a_51_n72# Gnd CMOSN w=20 l=2
+  ad=100p pd=30u as=100p ps=50u
M1070 a0 b0 a_n13_n359# vdd CMOSP w=40 l=2
+  ad=0.2n pd=90u as=0.2n ps=90u
M1071 a3 b3 a_n13_n907# vdd CMOSP w=40 l=2
+  ad=0.2n pd=90u as=0.2n ps=90u
M1072 p1 a_34_n572# gnd Gnd CMOSN w=10 l=2
+  ad=50p pd=30u as=50p ps=30u
M1073 a_259_n251# in2_NAND5 a_247_n251# Gnd CMOSN w=50 l=2
+  ad=0.25n pd=60u as=0.25n ps=60u
M1074 a_62_n64# in_ff a_51_n72# Gnd CMOSN w=10 l=2
+  ad=50p pd=30u as=50p ps=30u
M1075 vdd in4_NAND5 out_NAND5 vdd CMOSP w=20 l=2
+  ad=100p pd=30u as=100p ps=30u
M1076 p0 a_34_n390# gnd Gnd CMOSN w=10 l=2
+  ad=50p pd=30u as=50p ps=30u
M1077 p3 a_34_n938# gnd Gnd CMOSN w=10 l=2
+  ad=50p pd=30u as=50p ps=30u
M1078 a_n6_n659# a1 gnd Gnd CMOSN w=20 l=2
+  ad=100p pd=30u as=100p ps=50u
M1079 a_133_n10# a_98_n10# w_49_n36# w_49_n36# CMOSP w=20 l=2
+  ad=100p pd=50u as=100p ps=50u
M1080 vdd in4_NAND4 out_NAND4 vdd CMOSP w=20 l=2
+  ad=100p pd=50u as=100p ps=30u
M1081 a_133_n10# clk a_133_n50# Gnd CMOSN w=20 l=2
+  ad=100p pd=50u as=100p ps=30u
M1082 vdd b3 g3_inv vdd CMOSP w=20 l=2
+  ad=100p pd=50u as=100p ps=30u
M1083 vdd b2 g2_inv vdd CMOSP w=20 l=2
+  ad=100p pd=50u as=100p ps=30u
M1084 out_ff a_133_n10# w_49_n36# w_49_n36# CMOSP w=20 l=2
+  ad=100p pd=50u as=100p ps=50u
M1085 a_163_n234# in3_NAND4 a_151_n234# Gnd CMOSN w=40 l=2
+  ad=0.2n pd=50u as=0.2n ps=50u
M1086 g3 g3_inv vdd vdd CMOSP w=20 l=2
+  ad=100p pd=50u as=100p ps=50u
M1087 a_34_n572# a_n13_n541# vdd vdd CMOSP w=20 l=2
+  ad=100p pd=50u as=100p ps=50u
M1088 a_65_n217# in1_NAND3 gnd Gnd CMOSN w=30 l=2
+  ad=0.15n pd=40u as=0.15n ps=70u
M1089 g2 g2_inv vdd vdd CMOSP w=20 l=2
+  ad=100p pd=50u as=100p ps=50u
M1090 vdd in2_NAND2 out_NAND2 vdd CMOSP w=20 l=2
+  ad=100p pd=50u as=100p ps=30u
M1091 b1 a1 a_n13_n541# vdd CMOSP w=40 l=2
+  ad=0.2n pd=90u as=0.2n ps=90u
M1092 a_34_n756# a_n13_n725# gnd Gnd CMOSN w=10 l=2
+  ad=50p pd=30u as=50p ps=30u
M1093 b3 a3 a_n13_n907# vdd CMOSP w=40 l=2
+  ad=0.2n pd=90u as=0.2n ps=90u
M1094 b0 a0 a_n13_n359# vdd CMOSP w=40 l=2
+  ad=0.2n pd=90u as=0.2n ps=90u
M1095 a_271_n251# in3_NAND5 a_259_n251# Gnd CMOSN w=50 l=2
+  ad=0.25n pd=60u as=0.25n ps=60u
M1096 out_NAND5 in1_NAND5 vdd vdd CMOSP w=20 l=2
+  ad=100p pd=30u as=100p ps=50u
M1097 g3_inv b3 a_n6_n1025# Gnd CMOSN w=20 l=2
+  ad=100p pd=50u as=100p ps=30u
M1098 out_NAND5 in5_NAND5 vdd vdd CMOSP w=20 l=2
+  ad=100p pd=50u as=100p ps=30u
M1099 out_NAND4 in1_NAND4 vdd vdd CMOSP w=20 l=2
+  ad=100p pd=30u as=100p ps=50u
C0 a_62_n64# clk 0.341152f
C1 a_62_n30# w_49_n36# 6.79e-20
C2 a0 g0_inv 0.036296f
C3 b3 g3_inv 0.153419f
C4 g2_inv gnd 0.25044f
C5 a_n13_n907# a_34_n938# 0.059344f
C6 out_xor vdd 0.214182f
C7 b1 gnd 0.114196f
C8 a1 g1_inv 0.036296f
C9 a_34_n572# gnd 0.262811f
C10 in5_NAND5 a_271_n251# 2.83e-19
C11 a_271_n251# gnd 1.36e-19
C12 in_inv vdd 0.020614f
C13 in1_NAND5 out_NAND5 0.001572f
C14 in5_NAND5 gnd 0.0559f
C15 vdd a_n13_n907# 0.31023f
C16 in4_NAND4 a_139_n234# 2.83e-19
C17 a_51_n72# a_98_n50# 1.36e-19
C18 in2_NAND3 gnd 8.87e-19
C19 vdd b2 0.067865f
C20 vdd a_34_n390# 0.467651f
C21 a_133_n10# out_ff 0.059344f
C22 in_inv out_inv 0.059344f
C23 in1_NAND3 in3_NAND3 0.007681f
C24 vdd in4_NAND4 0.020473f
C25 vdd a_34_n938# 0.467651f
C26 a_62_n64# a_98_n10# 0.163856f
C27 g2_inv g2 0.059344f
C28 a_62_n64# w_49_n36# 0.020872f
C29 b2 a2 0.626439f
C30 a_34_n390# p0 0.059344f
C31 b0 a_n6_n477# 1.7e-19
C32 g2 gnd 0.123737f
C33 a3 g3_inv 0.036296f
C34 in1_NAND2 vdd 0.020614f
C35 a_34_n572# p1 0.059344f
C36 p1 gnd 0.103118f
C37 in5_NAND5 a_283_n251# 1.7e-19
C38 out_inv vdd 0.214194f
C39 a_283_n251# gnd 1.36e-19
C40 in2_NAND5 out_NAND5 0.00699f
C41 out_NAND2 gnd 2.27e-20
C42 in4_NAND4 a_151_n234# 2.83e-19
C43 a_51_n72# a_133_n50# 1.36e-19
C44 in1_NAND3 out_NAND3 0.036296f
C45 in3_NAND3 gnd 0.0559f
C46 a_34_n938# p3 0.059344f
C47 vdd a2 0.046605f
C48 vdd p0 0.214182f
C49 a_133_n10# a_51_n72# 0.304049f
C50 in2_NAND3 in3_NAND3 0.339028f
C51 vdd in1_NAND5 0.020614f
C52 vdd p3 0.214182f
C53 a_51_n72# clk 0.059299f
C54 out_ff w_49_n36# 0.22794f
C55 b2 a_n13_n725# 1.51355f
C56 b1 g1_inv 0.153419f
C57 a_n6_n843# gnd 1.36e-19
C58 b3 a_n6_n1025# 1.7e-19
C59 g1_inv gnd 0.25044f
C60 b0 gnd 0.114196f
C61 in3_NAND5 out_NAND5 0.007111f
C62 out_NAND3 gnd 2.27e-20
C63 in4_NAND4 a_163_n234# 1.7e-19
C64 in2_NAND3 out_NAND3 0.106322f
C65 in1_NAND4 gnd 0.001614f
C66 vdd a_n13_n725# 0.31023f
C67 vdd g0_inv 0.468501f
C68 vdd in2_NAND5 0.020472f
C69 vdd g3_inv 0.468501f
C70 a_98_n50# clk 5.16e-20
C71 a_51_n72# a_98_n10# 0.042875f
C72 a_212_n29# gnd 0.180335f
C73 a2 a_n13_n725# 0.90085f
C74 in1_xor gnd 0.056598f
C75 b3 gnd 0.114196f
C76 g1 gnd 0.123737f
C77 a0 gnd 0.001614f
C78 in4_NAND5 out_NAND5 0.007111f
C79 out_NAND4 gnd 2.27e-20
C80 a_65_n217# gnd 1.36e-19
C81 in2_NAND2 a_n6_n200# 1.7e-19
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
.control
run

* meas tran tpdr TRIG V(b0) VAL=0.9 RISE=1 TARG V(s0) VAL=0.9 RISE=1 $ FROM=25n TO=35n
* meas tran tpdf TRIG V(b0) VAL=0.9 FALL=1 TARG V(s0) VAL=0.9 FALL=1 $ FROM=45n TO=55n
* let t_delay = 0.5*(tpdr + tpdf)
* print tpdr tpdf t_delay

plot a2 3+b2 6+p2 9+g2 12+g2_inv

.endc
.end
